JelmerV/RV-Reducer/RV_Reducer_Poster-JelmerVolbeda-DesignForAM.pdf

# High-torque

# High-precisionRobotic Actuator

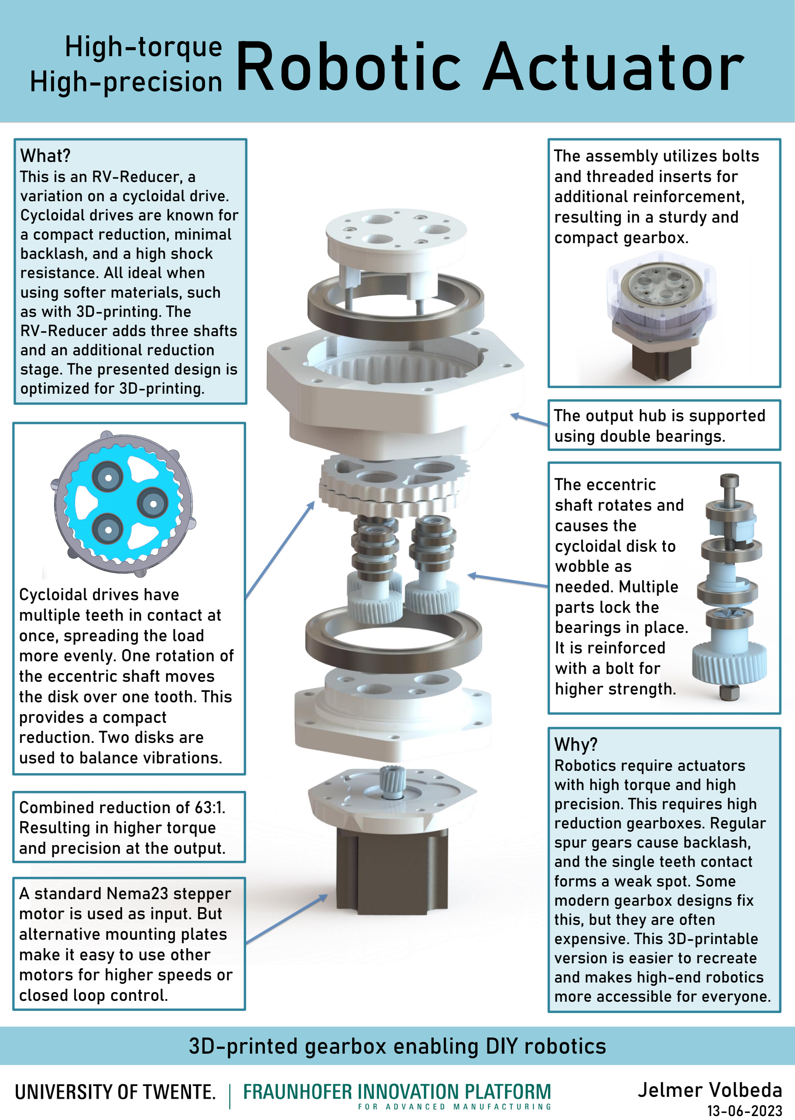
[picture p1: page 1]

Why?
Robotics require actuators with high torque and high
precision. This requires high reduction gearboxes. Regular spur gears cause backlash, and the single teeth contact forms a weak spot. Some
modern gearbox designs fix this, but they are often
expensive. This 3D-printable version is easier to recreate and makes high-end robotics more accessible for everyone.

What?
This is an RV-Reducer, a
variation on a cycloidal drive. Cycloidal drives are known for a compact reduction, minimal backlash, and a high shock resistance. All ideal when using softer materials, such as with 3D-printing. The
RV-Reducer adds three shafts and an additional reduction stage. The presented design is optimized for 3D-printing. The output hub is supported using double bearings.

Cycloidal drives have
multiple teeth in contact at once, spreading the load
more evenly. One rotation of the eccentric shaft moves
the disk over one tooth. This provides a compact
reduction. Two disks are
used to balance vibrations.

A standard Nema23 stepper
motor is used as input. But alternative mounting plates make it easy to use other
motors for higher speeds or closed loop control.

Combined reduction of 63:1. Resulting in higher torque and precision at the output.

## 3D-printed gearbox enabling DIY robotics

The eccentric
shaft rotates and
causes the
cycloidal disk to
wobble as
needed. Multiple
parts lock the
bearings in place.
It is reinforced
with a bolt for
higher strength.

### Jelmer Volbeda

13-06-2023

The assembly utilizes bolts and threaded inserts for
additional reinforcement,
resulting in a sturdy and
compact gearbox.
