JelmerV/RV-Reducer/CAD/Base Assembly.SLDASM

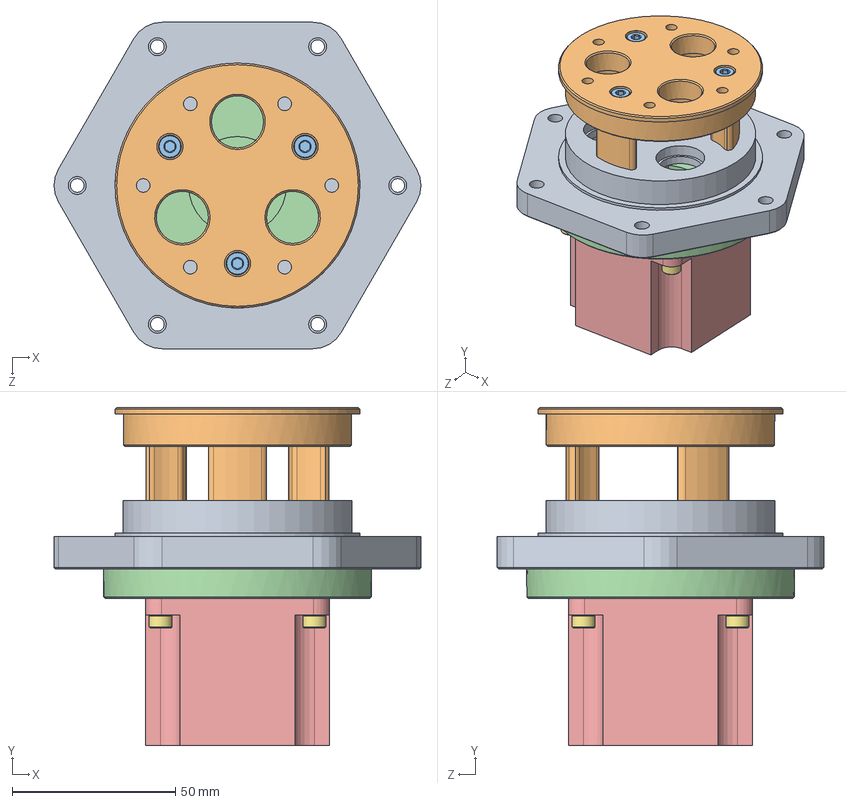
[picture p2: CAD file, 2023-09-04]
CAD/Base Assembly.SLDASM
112.4 x 103.5 x 100.0 mm
Base - Gear Housing
Base - Top Cap
DIN912-M4x40 x 3
Base - Motor Mount
NEMA23 Stepper motor
Heat-Set Insert - m4 5.5x6mm x 4
DIN912-M4x12 x 8
