JelmerV/RV-Reducer/CAD/V1.3 exported/Output Assembly.STEP

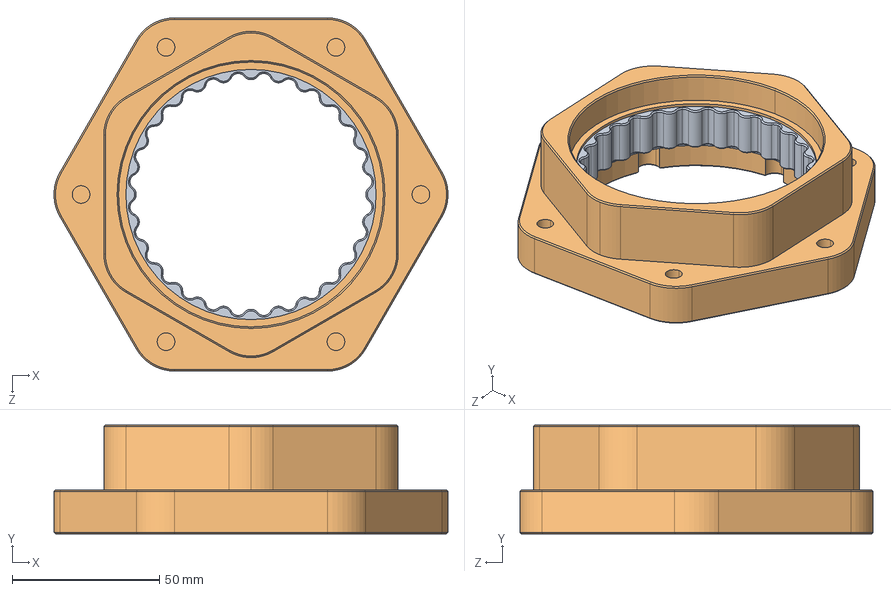
[picture p3: CAD file, 2023-09-04]
CAD/V1.3 exported/Output Assembly.STEP
133.9 x 37.0 x 120.0 mm
