JelmerV/RV-Reducer/CAD/Wobbler Assem.SLDASM

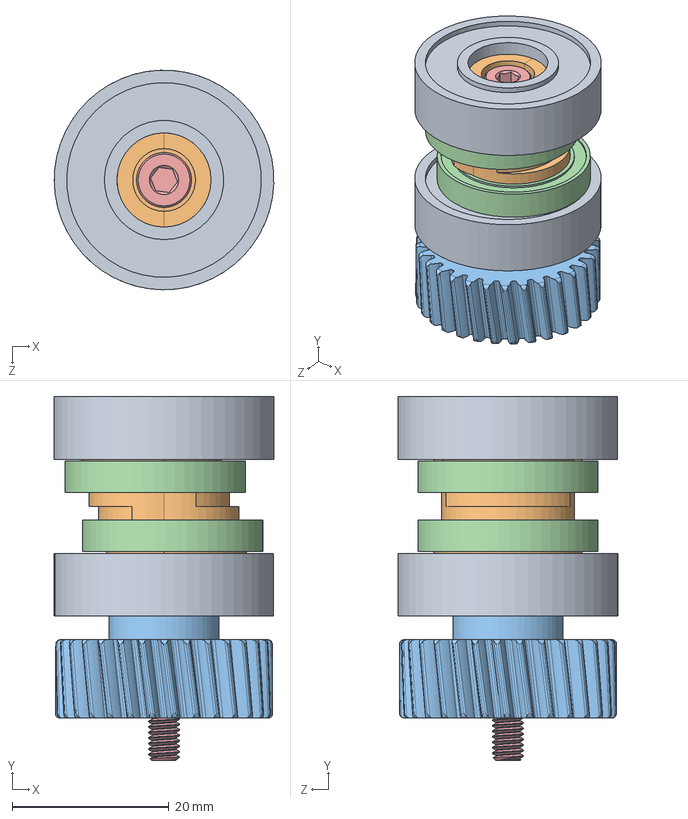
[picture p4: CAD file, 2023-09-04]
CAD/Wobbler Assem.SLDASM
28.0 x 46.4 x 28.0 mm
Eccentric Shaft - FDM
Spur Gear
bearing x 4
DIN912-M4x40
DIN985-M4-Locknut
