JelmerV/RV-Reducer/CAD/plasma z-axis.SLDASM

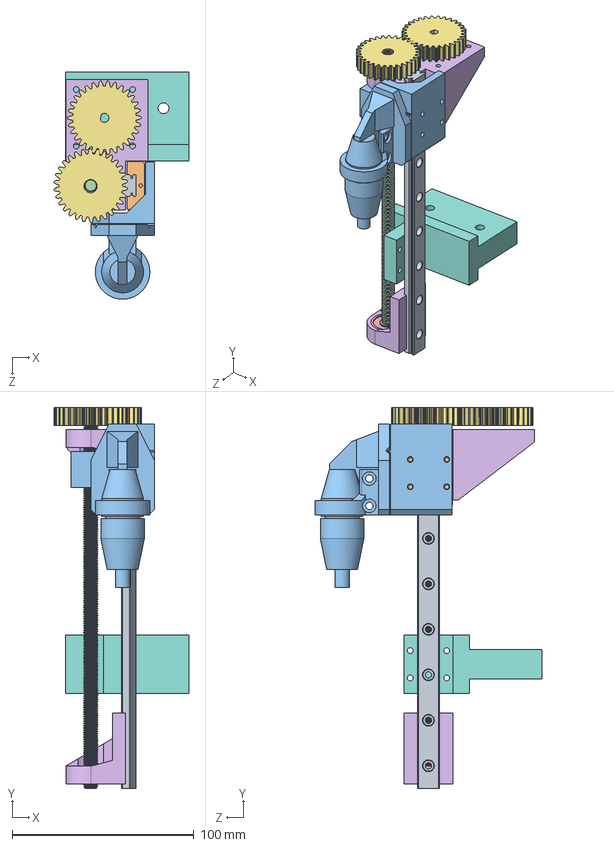
[picture p5: CAD file, 2023-09-04]
CAD/plasma z-axis.SLDASM
74.2 x 209.5 x 125.0 mm
MGNR12 Rail
MGN12CH Carriage
plasma torch holder
Threaded rod M8
bearing
Bearing mount x 2
Spur Gears x 2
z-axis mount
