JelmerV/RV-Reducer/CAD/V1.3 exported/Spur Gear - large.SLDPRT

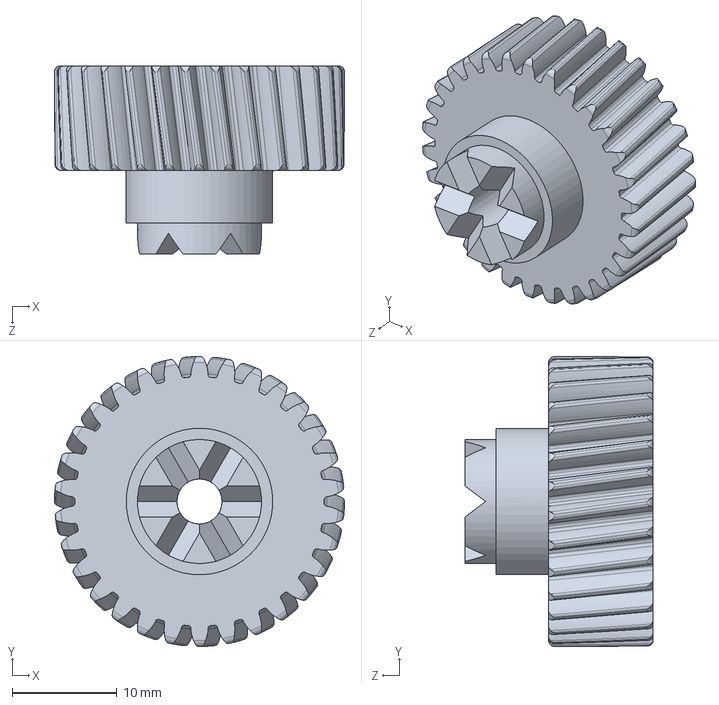
[picture p6: CAD file, 2023-09-04]
CAD/V1.3 exported/Spur Gear - large.SLDPRT
27.7 x 27.7 x 18.0 mm
