JelmerV/RV-Reducer/CAD/Eccentric Shaft - FDM.SLDPRT

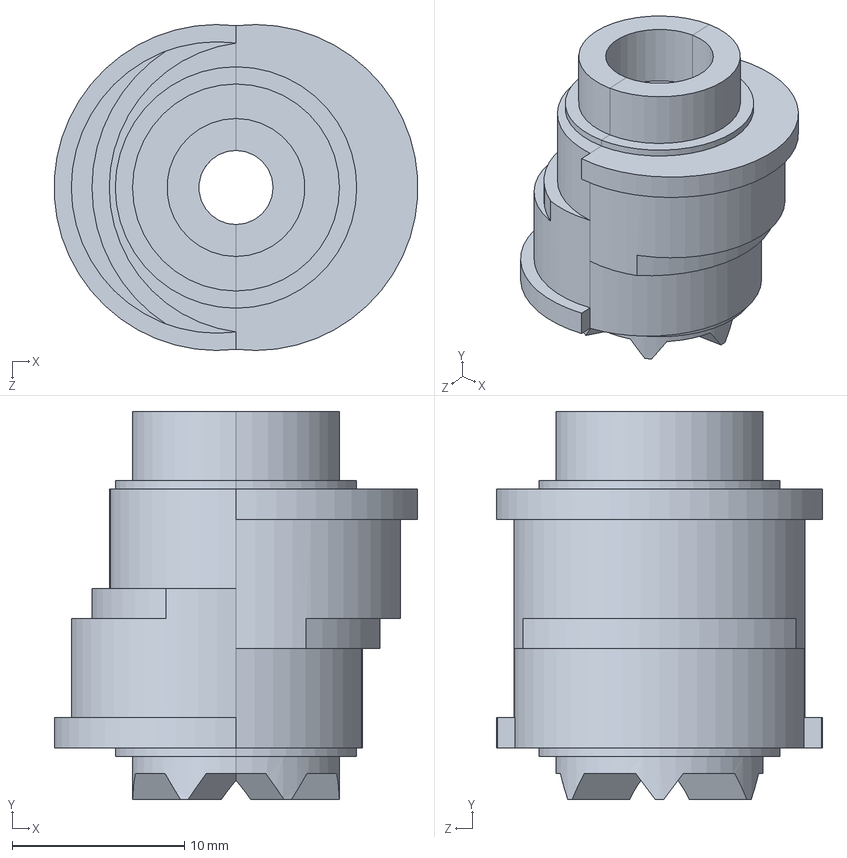
[picture p7: CAD file, 2023-09-04]
CAD/Eccentric Shaft - FDM.SLDPRT
21.1 x 22.5 x 18.9 mm
