JelmerV/RV-Reducer/CAD/V1.3 exported/Cycloidal Disk.STL

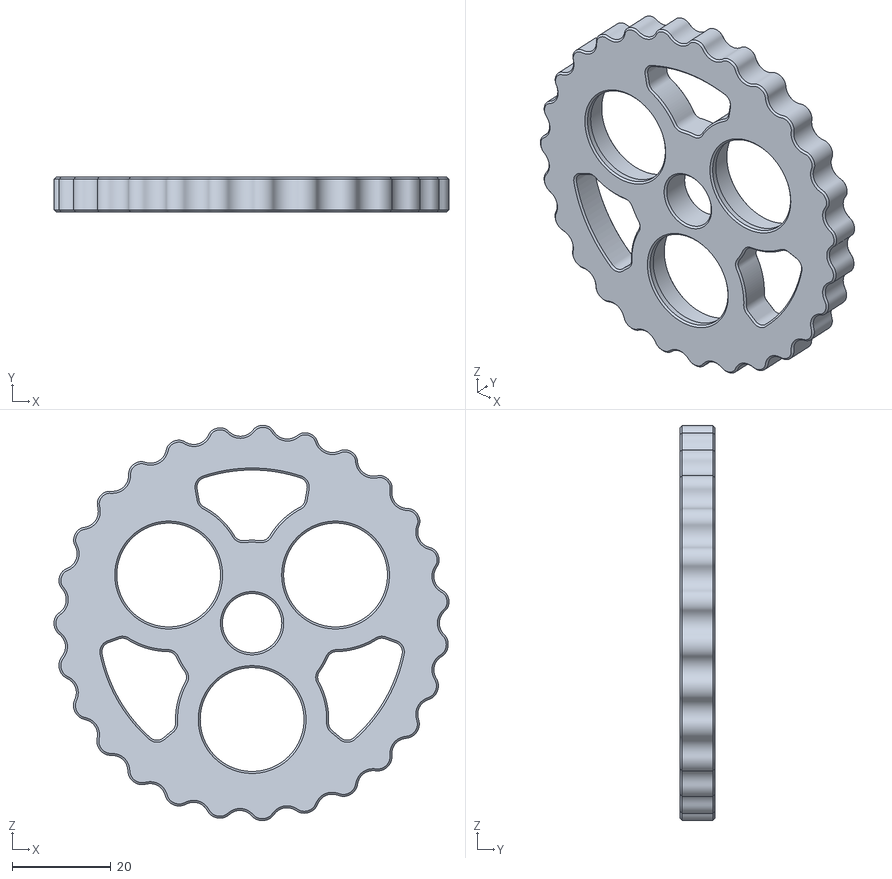
[picture p8: CAD file, 2023-09-04]
CAD/V1.3 exported/Cycloidal Disk.STL
79.9 x 7.00 x 80.0
