JelmerV/RV-Reducer/CAD/Base - Gear Housing.SLDPRT

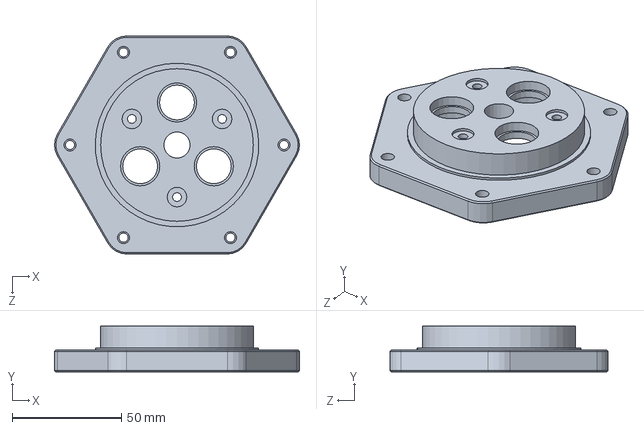
[picture p9: CAD file, 2023-09-04]
CAD/Base - Gear Housing.SLDPRT
112.4 x 21.0 x 100.0 mm
