JelmerV/RV-Reducer/CAD/Base - Top Cap.SLDPRT

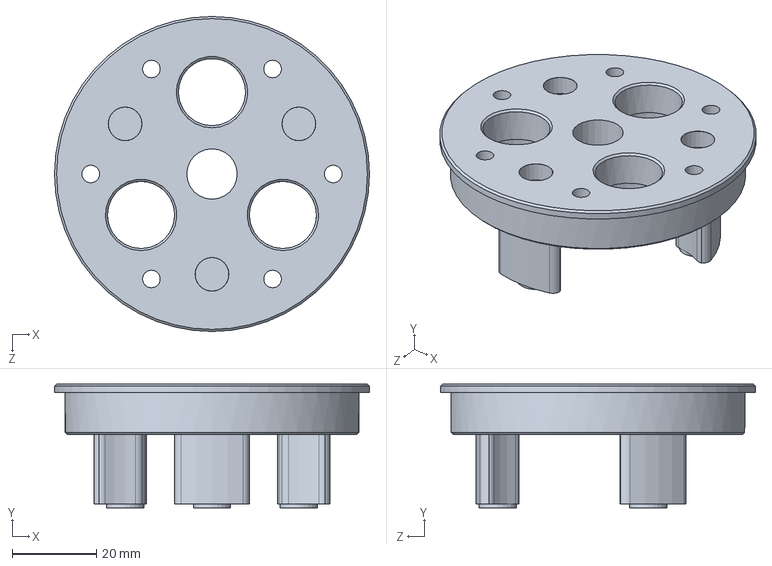
[picture p10: CAD file, 2023-09-04]
CAD/Base - Top Cap.SLDPRT
75.0 x 29.5 x 75.0 mm
