JelmerV/RV-Reducer/CAD/Eccentric Shaft.SLDPRT

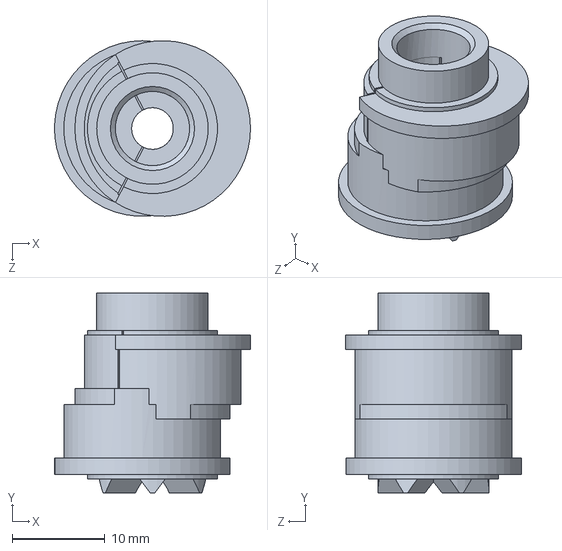
[picture p11: CAD file, 2023-09-04]
CAD/Eccentric Shaft.SLDPRT
21.1 x 21.5 x 18.9 mm
