JelmerV/RV-Reducer/CAD/bearing.SLDPRT

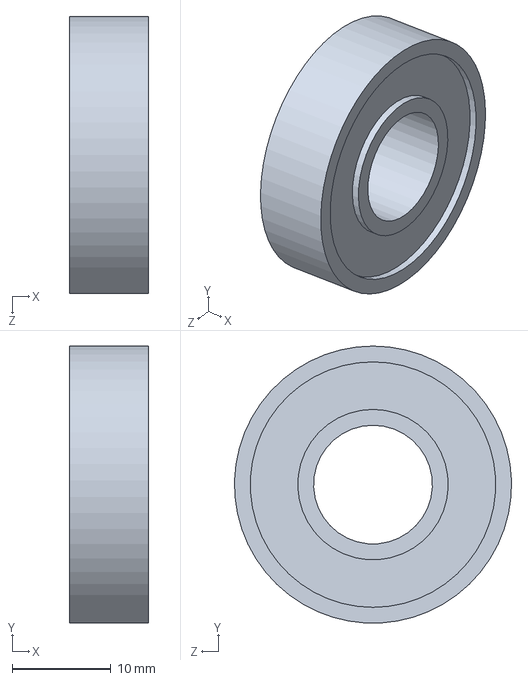
[picture p12: CAD file, 2023-09-04]
CAD/bearing.SLDPRT
8.00 x 28.0 x 28.0 mm
