JelmerV/RV-Reducer/CAD/Bearing mount.SLDPRT

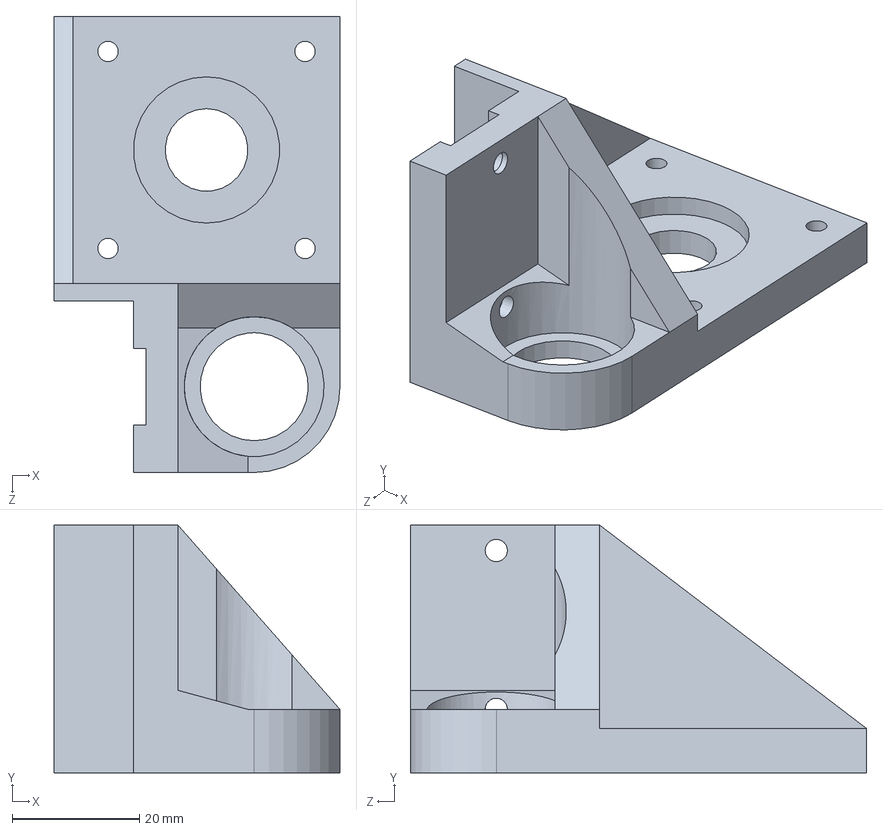
[picture p13: CAD file, 2023-09-04]
CAD/Bearing mount.SLDPRT
45.0 x 39.0 x 71.8 mm
