JelmerV/RV-Reducer/CAD/Base - Motor Mount.SLDPRT

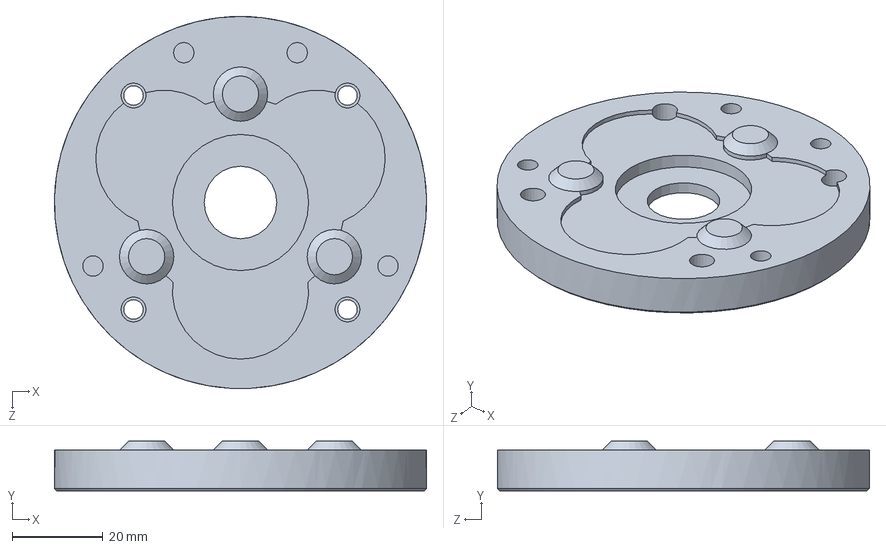
[picture p14: CAD file, 2023-09-04]
CAD/Base - Motor Mount.SLDPRT
82.0 x 11.0 x 82.0 mm
