JelmerV/RV-Reducer/CAD/rv_reducer_basepart.SLDPRT

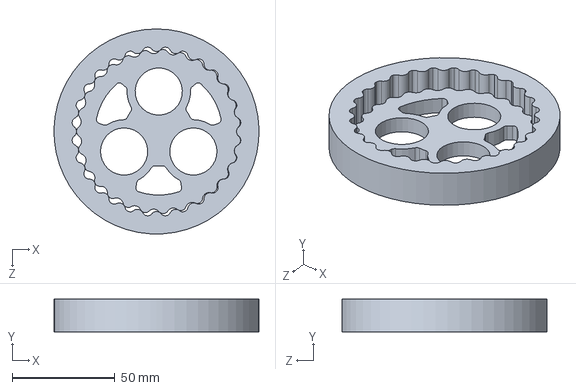
[picture p15: CAD file, 2023-07-23]
CAD/rv_reducer_basepart.SLDPRT
100.0 x 16.0 x 100.0 mm
