JelmerV/RV-Reducer/CAD/Heat-Set Insert - m4 5.5x6mm.SLDPRT

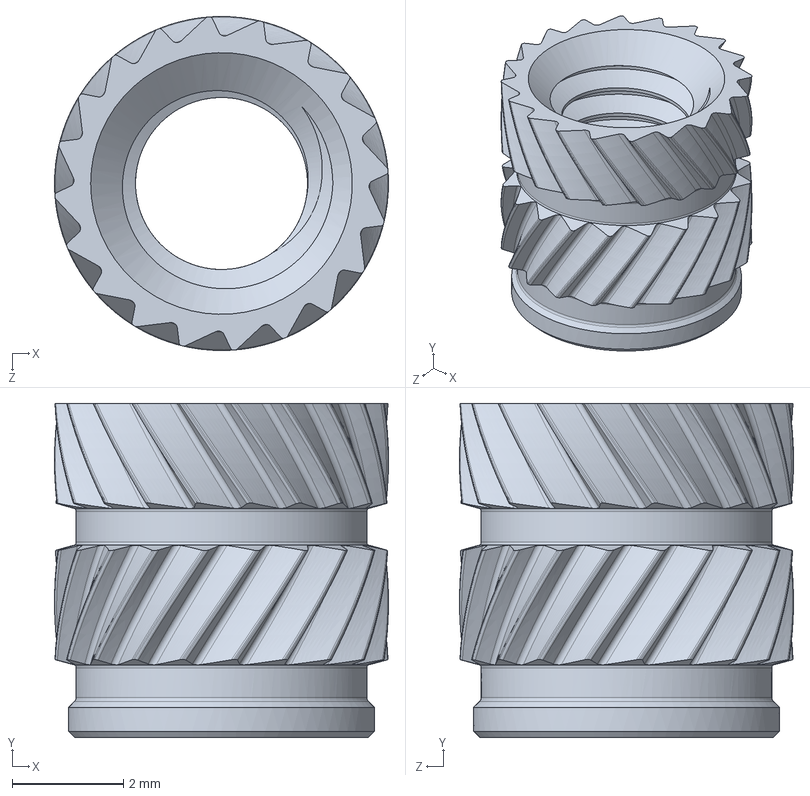
[picture p16: CAD file, 2023-07-23]
CAD/Heat-Set Insert - m4 5.5x6mm.SLDPRT
6.00 x 6.00 x 6.00 mm
