JelmerV/RV-Reducer/CAD/NEMA23 Stepper motor.SLDPRT

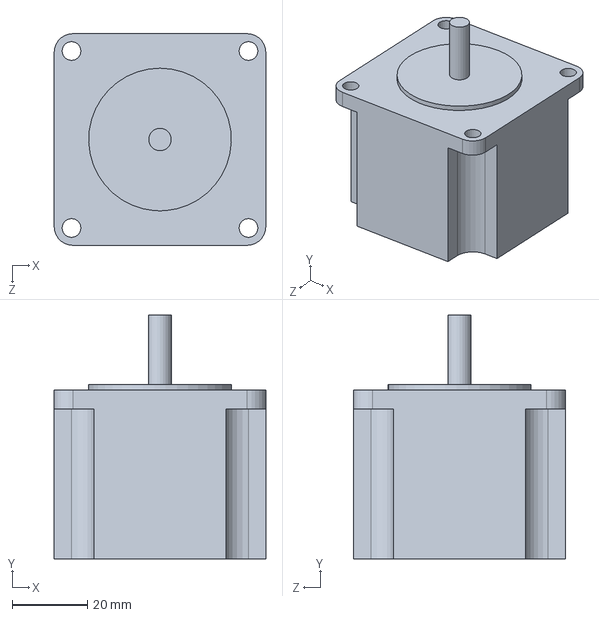
[picture p17: CAD file, 2023-07-23]
CAD/NEMA23 Stepper motor.SLDPRT
56.4 x 65.0 x 56.4 mm
