JelmerV/RV-Reducer/(list of files, cad)

Other CAD files:
CAD/Output Assembly.sldprt
CAD/V1.3 exported/Eccentric Shaft - FDM.STEP
CAD/Spur Gear.SLDPRT
CAD/Cycloidal Disk.SLDPRT
CAD/DIN912-M4x12.SLDPRT
CAD/DIN912-M4x40.SLDPRT
CAD/DIN985-M4-Locknut.SLDPRT
CAD/nut.SLDPRT
